cklaw25/unibots-mark2-uncomplete/pin codes details/extra stuff since 216/schematicdiagramnew.jpeg

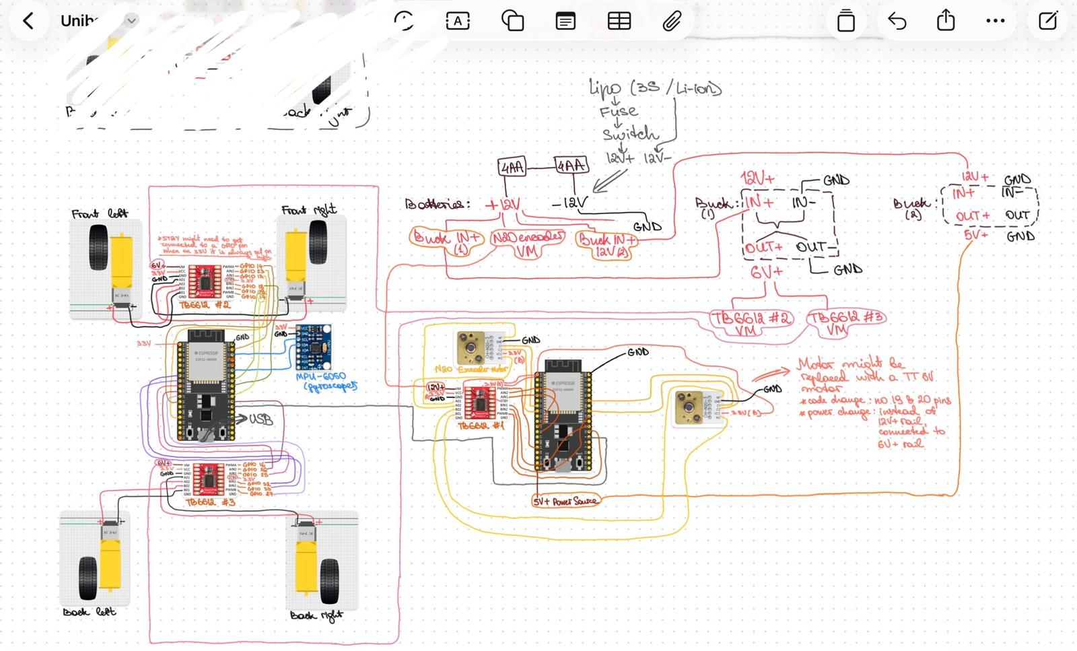
pin codes details/extra stuff since 216/schematicdiagramnew.jpeg
