cklaw25/unibots-mark2-uncomplete/pin codes details/pin code png.jpg

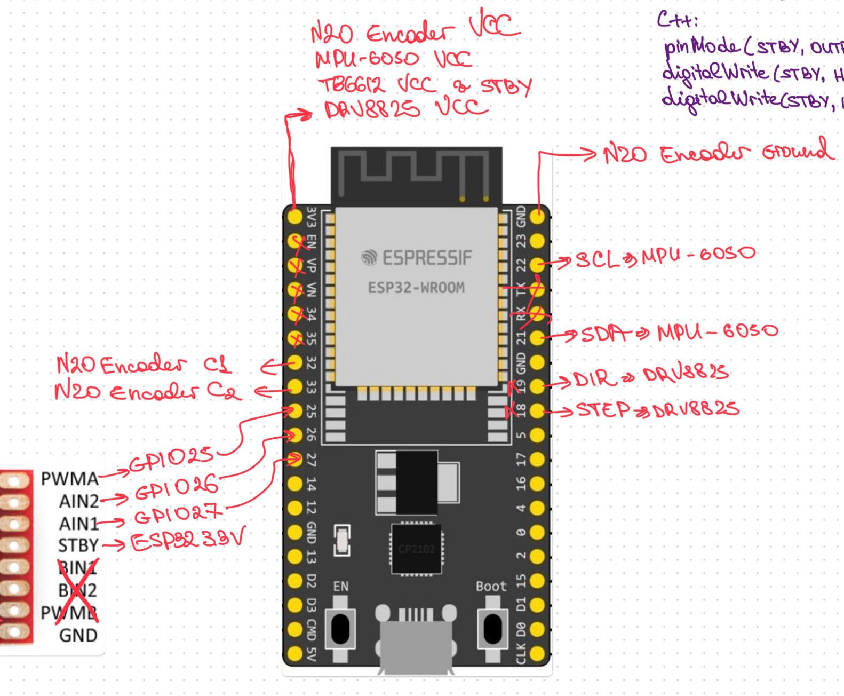
pin codes details/pin code png.jpg
