cklaw25/unibots-mark2-uncomplete/pin codes details/pin code png 2.jpg

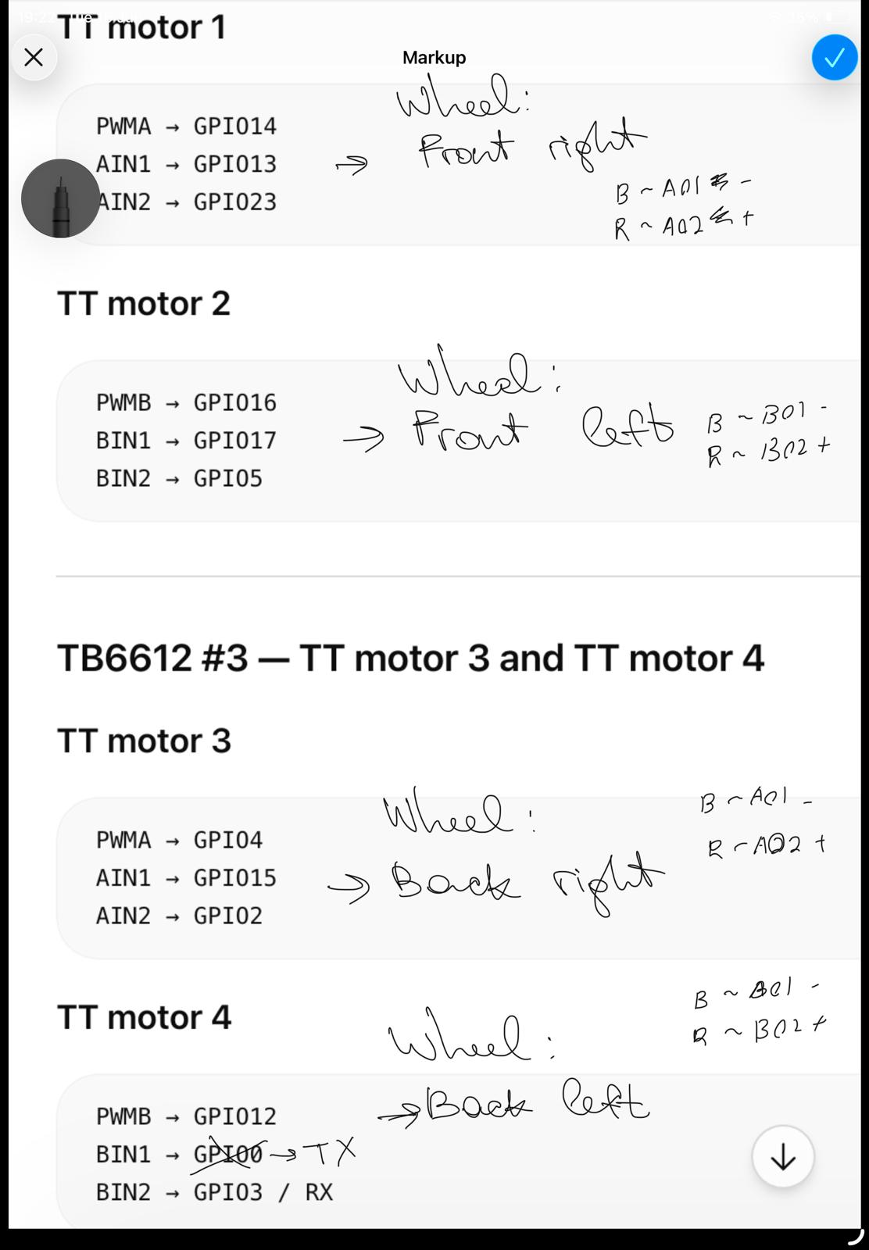
pin codes details/pin code png 2.jpg
