cklaw25/unibots-mark2-uncomplete/pin codes details/pin codes.jpeg

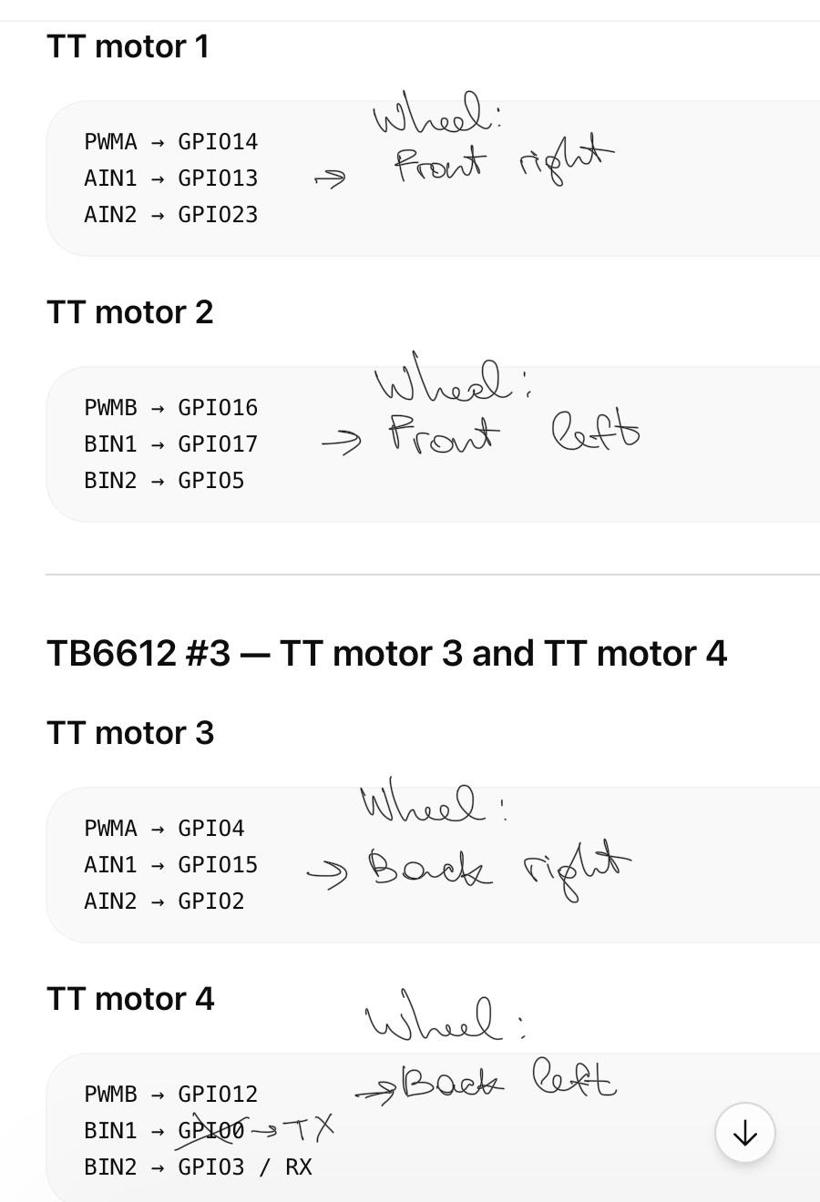
pin codes details/pin codes.jpeg
