cklaw25/unibots-mark2-uncomplete/rulebook arena dimensions/bot design.png

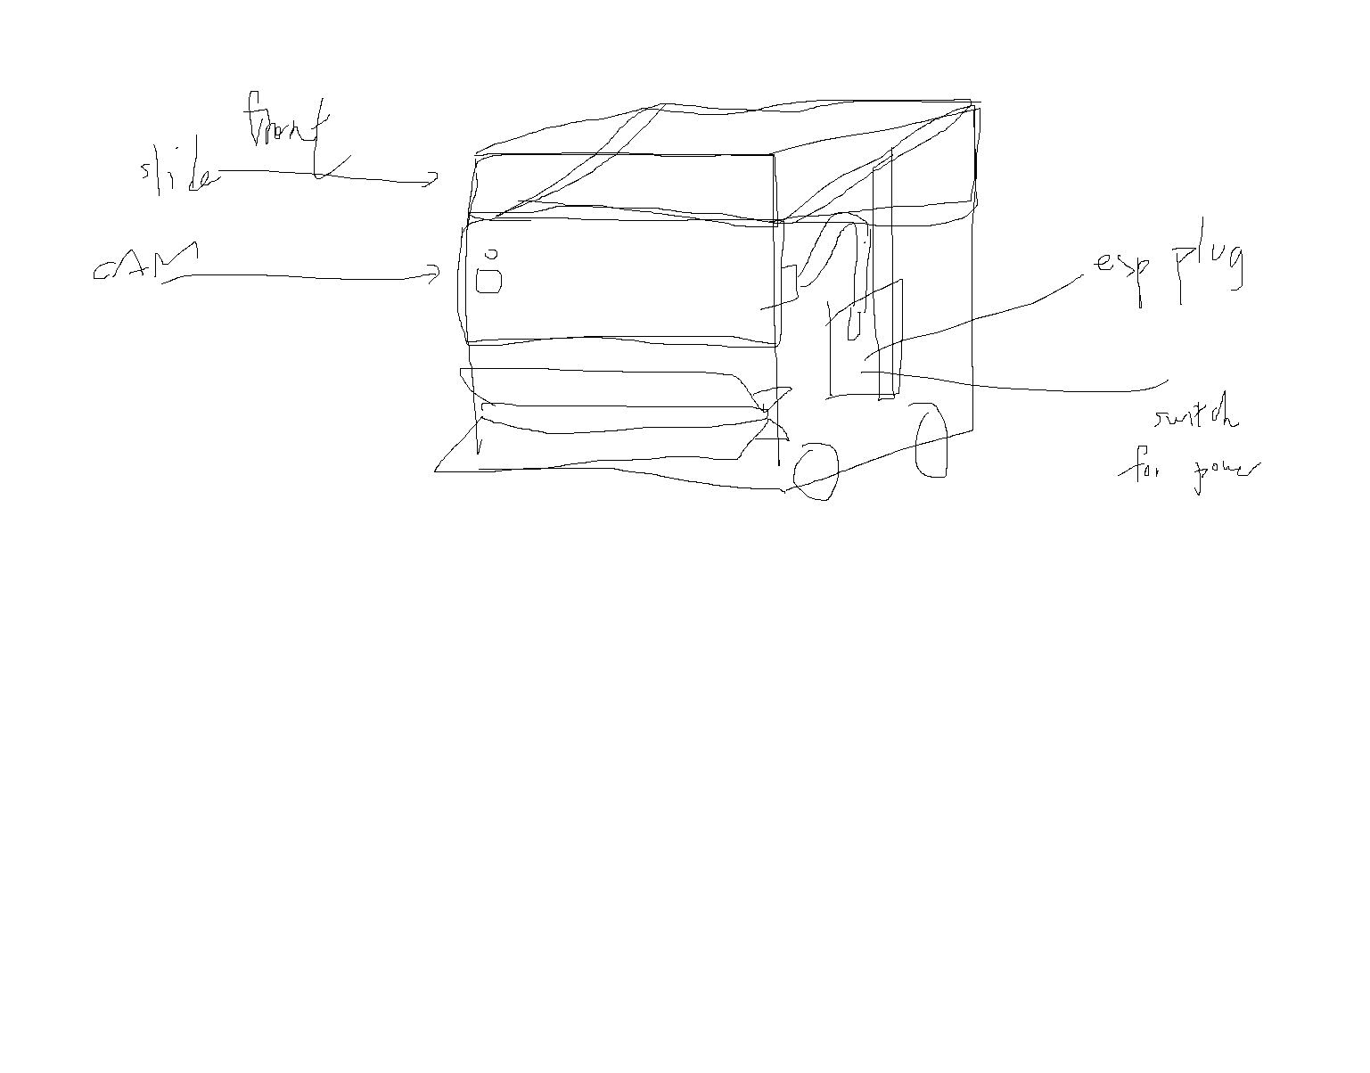
rulebook arena dimensions/bot design.png
