cklaw25/unibots-mark2-uncomplete/rulebook arena dimensions/Screenshot 2026-06-10 113742.png

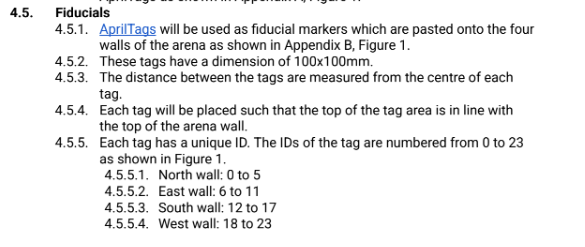
rulebook arena dimensions/Screenshot 2026-06-10 113742.png
