cklaw25/unibots-mark2-uncomplete/(commit log)

2026-06-15 Initial commit — UnibotsMarkII (Elegoo V4, odometry return-to-start)
    Mode 1: ball scan-step + approach FSM, gyro heading-hold
    Mode 2: dead-reckoning odometry return-to-start, linear actuator deposit
    Python simulation for nav testing without hardware
    All motor/actuator pins are placeholders — fill in before flashing
2026-06-15 Fix: odometry is permanent, not replaced by AprilTag nav
2026-06-15 Update conversation log — session 2 (git setup + clarifications)
2026-06-15 Update conversation log — session 3 (simulation + vision test run)
2026-06-17 Add UnibotsMainV2 firmware, Android app, and new README
    - arduino/UnibotsMainV2/UnibotsMainV2.ino: combined match firmware with
    confirmed 4-motor pin map, corrected heading-hold, Mode 1/2 FSM,
    odometry return path, stepper stubs. TT4 re-routed to GPIO18/19.
    - arduino/HardwareTest/HardwareTest.ino: bench test tool (for reference)
    - android/: YOLO11 ball-detection Android app (from Mark 4, unchanged)
    - README.md: rewritten for new user — project summary, pin map, 4 pre-flash
    reminders, and Claude workflow instructions (check → flash ESP32 → flash Android)
    - CONVERSATION_LOG.md: updated with Sessions 6 and 7
    [yolo11m.ncnn.param, yolo11m_cls.ncnn.param, yolo11m_obb.ncnn.param, yolo11m_pose.ncnn.param, yolo11m_seg.ncnn.param, yolo11n.ncnn.param, yolo11n_cls.ncnn.param, yolo11n_obb.ncnn.param]
2026-06-17 Update conversation log — session 8
2026-06-21 Session 9: two-board rewrite — BoardA, BoardB, Android, README
    - BoardA.ino: complete rewrite with new pin map (schematic_two_board),
    GPIO4 trigger protocol, motor test mode at boot (t/1-4/a/d/q commands),
    MS_PER_MM distance calibration via 'd' command, fixed currentMode bug
    - BoardB.ino: new firmware for N20 spinner + lift, encoder-based 90deg
    gate control, GPIO4 level/pulse detection, Serial test commands (m/l)
    - Android MainActivity: removed Task5/6 auto-switch, added live ESP32
    status label (green/red, polls every 2s), auto-connect USB on resume,
    auto-select ball detection task on launch
    - Android main.xml: added textStatusUsb TextView to button row
    - README: complete from-sc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
    [BoardA.ino, BoardB.ino, MainActivity.java]
2026-06-21 Update conversation log — session 9 complete
2026-06-21 Update conversation log — session 9 final state + calibration data checklist
2026-06-24 Update Board A pin map from teammate schematic (new pins 246)
    All 4 TT motor pins reassigned per updated TB6612 wiring:
    - TT1 front-right: PWM=32 IN1=25 IN2=33
    - TT2 front-left: PWM=14 IN1=26 IN2=27
    - TT3 back-right: PWM=13 IN1=17 IN2=16
    - TT4 back-left: PWM=23 IN1=18 IN2=19
    Updated BoardA.ino, README pin map table, and README example.
    Added new schematic file (pin codes details/new pins 246/).
    Board B unchanged.
2026-06-24 Update conversation log — session 10 pin map update
